AngelMzno/Sense-Termocarbox-V1/README.md

# Sense-Termocarbox-V1

Proyecto de migracion del equipo de termocarboxiterapia S Carbox de PIC + Nextion a STM32G431 + DWIN.

## Estado actual

- Bloque 0/1: requisitos y arquitectura de hardware documentados.
- Bloque 2: esquematico y layout PCB completados en EasyEDA Pro.
- Hardware: DRC sin fatal errors ni errores electricos, ratlines sin pendientes y Gerbers exportados para revision previa a fabricacion.
- Firmware: proyecto STM32CubeMX inicial en `Firrmware/`.

Ver `hardware/README.md` para el detalle de archivos de EasyEDA, BOM y Gerbers.
