AngelMzno/Sense-Termocarbox-V1/docs/05-diseno-pcb.md

# Diseño de PCB — Bloque 2

**Documento:** PCB-001 | **Revisión:** 01 | **Estado:** Layout completado para revisión Gerber — herramienta: EasyEDA Pro

## Estado del layout
- Esquemático capturado en EasyEDA Pro.
- PCB ruteada en 2 capas, con plano GND inferior.
- DRC sin fatal errors ni errores eléctricos.
- Ratlines revisadas sin conexiones pendientes.
- Gerber/Drill exportado como `hardware/Gerber_PCB1_2026-08-14.zip` para revisión previa a fabricación.
- Warnings conocidos: algunos conectores THT no tienen modelo 3D vinculado; no afecta fabricación.

## Política de componentes
MCU en SMD (obligatorio, no existe versión THT del STM32G431CBT6, encapsulado LQFP48). Todo lo demás (resistencias, capacitores, transistores/MOSFETs, diodos, reguladores) en THT por preferencia de facilidad de soldado y reparación en campo, salvo excepciones justificadas:
- Conversión 12V→5V usa módulo buck prearmado (IC interno SMD, pero módulo completo con headers, reemplazable como componente THT) para evitar pérdidas de potencia significativas de un regulador lineal en ese salto de voltaje.
- Capacitores cerámicos de desacoplo cercano del MCU en SMD 0603: C_VDD1, C_VDD2, C_VDD3, C_VDDA_100N y C_VDDA_1U. Esta excepción se justifica por integridad de señal y reducción de inductancia parásita: deben quedar lo más cerca posible de los pines VDD/VDDA del STM32G431CBT6 para filtrar ruido de alta frecuencia. No aplica al capacitor bulk C_BULK_3V3, que se mantiene THT.

## Fuente de reloj
Oscilador interno HSI16 del STM32G431 (sin cristal externo) — suficiente precisión para USART, PWM y ADC de esta aplicación; reduce componentes y puntos de falla mecánica frente a un cristal externo.

## Alimentación
- **12V → 5V:** módulo buck prearmado (tipo MP1584EN o LM2596), mínimo 1A de salida
- **5V → 3.3V:** LM1117T-3.3 (LDO fijo, TO-220/THT). Se descartó LM317 por dropout insuficiente (2-3V típico) frente al margen disponible de solo 1.7V (5V-3.3V)
- **Protección de entrada 12V:** diodo Schottky 1N5822 (THT, 3A) en serie, contra polaridad inversa
- **Desacoplo del MCU:** 100nF cerámico SMD 0603 en cada pin VDD + 1 capacitor bulk THT de 4.7-10µF. VDDA con 1µF SMD 0603 + 100nF SMD 0603 separados, con ferrita/inductor entre VDD y VDDA para aislar ruido digital de la parte analógica (crítico para lecturas limpias de ADC)

**Decisiones de captura cerradas:**
- VREF+ conectado a VDDA; no se usará referencia externa de ADC.
- VBAT conectado a 3.3V; no se usará batería de respaldo.
- LM1117T-3.3 con capacitor de entrada de 10µF entre +5V y GND, y capacitor de salida de 10µF entre 3.3V y GND, colocados cerca del regulador.
- Módulo buck mini DC-DC ajustable configurado/soldado a 5V antes de instalar. Pinout capturado: EN, IN+, GND, V+. EN amarrado a +12V para operación siempre habilitada; IN+ a +12V; GND a GND; V+ a +5V.

## Drivers de potencia
**MOSFET único para hotend y electroválvula:** IRLZ44N (TO-220, THT, nivel lógico) — mismo número de parte para ambos drivers, simplifica inventario de refacciones en campo.
- Resistencia de gate: 100-220Ω (limita corriente de carga inicial desde el GPIO)
- Resistencia de pull-down en gate: ~10kΩ (evita activación accidental del MOSFET durante arranque/reset del MCU, antes de que el firmware configure el GPIO)
- Electroválvula (carga inductiva): diodo flyback (1N4001 o equivalente) en paralelo con la bobina, para proteger el MOSFET del pico de voltaje inverso al apagar

**Driver del buzzer pasivo:** BS170 (MOSFET canal N, TO-92/THT) — mismo criterio de bajo consumo estático que el resto de drivers MOSFET, controlado por PWM desde PA6 (TIM3_CH1)
- Alimentación del buzzer desde +5V.
- Resistencia de gate: 220Ω.
- Resistencia pull-down en gate: 10kΩ.
- Componente de referencia capturado: PS1240P02BT, buzzer piezoeléctrico pasivo THT.

## Conectores capturados

- **J_DWIN:** BX-PH2.0-8PZZ, PH2.0 8 pines THT, LCSC C18077750. UART2 TTL/CMOS directo a PA9/PA10; no se usa MAX232/MAX3232. Pines RX4/TX4 quedan NC intencionalmente.
- **J_PEDAL:** bornera THT 2 pines paso 5.08mm. Un pin a GND/COM y el otro a PC13_PEDAL_NO con pull-up interno.
- **J_SWD:** header macho THT 2.54mm 1x5, LCSC C5156614. Incluye 3V3, SWDIO, SWCLK, NRST y GND.
- **J_HOTEND:** bornera THT 2 pines 5.08mm. Hotend entre +12V y drain de Q_HOTEND.
- **J_NTC_HOTEND:** header macho THT 2.54mm 1x2. NTC 100K B3950 en divisor contra R_NTC_PULLUP 100k a 3V3.
- **J_PRESSURE:** KF128-5.08-3P-AA, bornera THT 3 pines, LCSC C474953. +5V, GND y señal acondicionada hacia PA0.
- **J_DS18B20:** KF128-5.08-3P-AA, bornera THT 3 pines. 3V3, GND y DQ con pull-up 4.7k a 3V3.
- **J_BUZZER:** header macho THT 2.54mm 1x2. Buzzer alimentado desde +5V y conmutado por Q_BUZZER BS170.
- **J_TEST:** PH2.0 8 pines THT para medicion de banco. Pinout: 1 GND, 2 +12V, 3 +5V, 4 3V3, 5 PA0_PRESSURE_ADC, 6 PA1_NTC_ADC, 7 PB0_DS18B20_1WIRE, 8 PC13_PEDAL_NO. Serigrafia abreviada: GND, 12V, 5V, 3V3, PRESS, NTC, DS18, PED.

## Acondicionamiento de señales analógicas

**Sensor de presión (salida 5V → ADC 3.3V, PA0):**
- Divisor resistivo: R1=10kΩ, R2=15kΩ (relación 0.6 → escala 5V a 3.0V, con margen bajo el límite de 3.3V del ADC)
- Filtro RC anti-ruido: R=1kΩ, C=100nF (cutoff ~1.6kHz, filtra ruido de conmutación del PWM/electroválvula sin afectar velocidad de lectura)
- Protección: diodo zener 3.3-3.6V a tierra en el pin del ADC, como respaldo contra sobrevoltaje
- Justificación de nivel de protección elegido (Nivel 2: divisor + protección + filtro, sin aislamiento galvánico): todos los componentes comparten el mismo gabinete y tierra, por lo que un amplificador de aislamiento no está justificado en este diseño
