AngelMzno/Sense-Termocarbox-V1/hardware/Sense-Termocarbox-V1-BOM-v1.csv

No. | Quantity | Comment | Designator | Footprint | Value | Manufacturer Part | Manufacturer | Supplier Part | Supplier
1 | 3 | 10uF | C_BULK_3V3,C_LDO_IN,C_LDO_OUT | CAP-TH_BD4.0-P1.50-D0.8-FD | 10uF | KF106M025C05RR0VH2FP0 | Chengx(承兴) | C43846 | LCSC
2 | 5 | 100nF | C_PRESSURE_FILT,C_VDD1,C_VDD2,C_VDD3,C_VDDA_100N | CAP-TH_L5.0-W2.5-P5.00-D1.0 | 100nF | CC1H104MC1FD3F6C10MF | Dersonic(德尔创) | C254085 | LCSC
3 | 1 | 1uF | C_VDDA_1U | CAP-TH_L5.5-W3.5-P5.00-D1.2 | 1uF | FK26X7R1H105KRE06 | TDK | C2839237 | LCSC
4 | 1 | 1N4728ATR | D_PRESSURE_ZENER | DO-41_BD2.4-L4.7-P8.70-D0.9-RD |  | 1N4728ATR | onsemi(安森美) | C890041 | LCSC
5 | 1 | 1N5822 | D_PROT_12V | DO-201AD_BD5.3-L9.5-P13.50-D1.4-RD |  | 1N5822 | ST(意法半导体) | C915962 | LCSC
6 | 1 | 1N4001 | D_VALVE_FLYBACK | DO-41_BD2.6-L5.1-P9.00-D0.8-RD |  | 1N4001 | baocheng(宝乘) | C47018536 | LCSC
7 | 1 | RH3.5x0.8x9P52E | FB1 | BEAD-TH_BD3.5-L9.0-P13.00-D0.7 |  | RH3.5x0.8x9P52E | FH(风华) | C192455 | LCSC
8 | 1 | 4kHz | J_BUZZER | BUZ-TH_BD12.5-P5.00-D0.9 | 4kHz | PS1240P02BT | TDK | C76871 | LCSC
9 | 2 | KF128-5.08-3P-AA | J_DS18B20,J_PRESSURE | CONN-TH_3P-P5.08_KF128-5.08-3P |  | KF128-5.08-3P-AA | KEFA(科发) | C474953 | LCSC
10 | 2 | BX-PH2.0-8PZZ | J_DWIN,J_TEST | CONN-TH_8P-P2.00_BX-PH2.0-8PZZ |  | BX-PH2.0-8PZZ | Bossie(博锡) | C18077750 | LCSC
11 | 4 | 5.08-2A | J_HOTEND,J_PEDAL,J_PWR_IN,J_VALVE | CONN-TH_2P-P5.08_5.08-2A |  | 5.08-2A | DLL(德利) | C22394555 | LCSC
12 | 1 | HDR-M_2.54_1x2P | J_NTC_HOTEND | HDR-TH_2P-P2.54-V-M-1
13 | 1 | 2.54-1*5 | J_SWD | HDR-TH_5P-P2.54-V-M |  | 2.54-1*5 | ZHOURI(洲日) | C5156614 | LCSC
14 | 1 | BS170 | Q_BUZZER | TO-92-3_L4.9-W3.7-P1.27-L |  | BS170 | onsemi(安森美) | C111691 | LCSC
15 | 2 | IRLZ44NPBF | Q_HOTEND,Q_VALVE | TO-220-3_L10.0-W4.5-P2.54-T |  | IRLZ44NPBF | Infineon(英飞凌) | C38774 | LCSC
16 | 5 | 10kΩ | R_BOOT0_PD,R_BUZZER_PD,R_HOTEND_PD,R_PRESSURE_TOP,R_VALVE_PD | RES-TH_BD2.7-L6.2-P10.20-D0.4 | 10kΩ | MF1/4W-10K±1%-ST52 | VO(翔胜) | C2903232 | LCSC
17 | 1 | 220Ω | R_BUZZER_GATE | RES-TH_BD2.2-L6.5-P10.50-D0.6 | 220Ω | MF1/4W-220Ω±1% T | CCO(千志电子) | C127220 | LCSC
18 | 1 | 4.7kΩ | R_DS18B20_PULLUP | RES-TH_BD2.3-L6.5-P10.50-D0.5 | 4.7kΩ | MF1/4W-4.7KΩ±1% T | CCO(千志电子) | C119339 | LCSC
19 | 2 | 150Ω | R_HOTEND_GATE,R_VALVE_GATE | RES-TH_BD2.7-L6.2-P10.20-D0.4 | 150Ω | MF1/4W-150Ω±1%-ST52 | VO(翔胜) | C2903242 | LCSC
20 | 1 | 100kΩ | R_NTC_PULLUP | RES-TH_BD2.3-L6.5-P10.50-D0.5 | 100kΩ | MF1/4W-100KΩ±1% T | CCO(千志电子) | C119369 | LCSC
21 | 1 | 15kΩ | R_PRESSURE_BOT | RES-TH_BD2.7-L6.2-P10.20-D0.4 | 15kΩ | MF1/4W-15K±1%-ST26 | VO(翔胜) | C2903263 | LCSC
22 | 1 | 1kΩ | R_PRESSURE_FILT | RES-TH_BD2.7-L6.2-P10.20-D0.4 | 1kΩ | MF1/4W-1K±1%-ST52 | VO(翔胜) | C2903245 | LCSC
23 | 1 | STM32G431CBT6 | U1 | LQFP-48_L7.0-W7.0-P0.50-LS9.0-BL |  | STM32G431CBT6 | ST(意法半导体) | C529355 | LCSC
24 | 1 | HDR-M_2.54_1x4P | U_BUCK_5V | HDR-TH_4P-P2.54-V-M
25 | 1 | LM1117T-3.3 | U_LDO_3V3 | TO-220-3_L10.0-W4.5-P2.54-L |  | LM1117T-3.3 | HGSEMI(华冠) | C498321 | LCSC
