AngelMzno/Sense-Termocarbox-V1/hardware/Sense-Termocarbox-V1-esquematico-v1.pdf

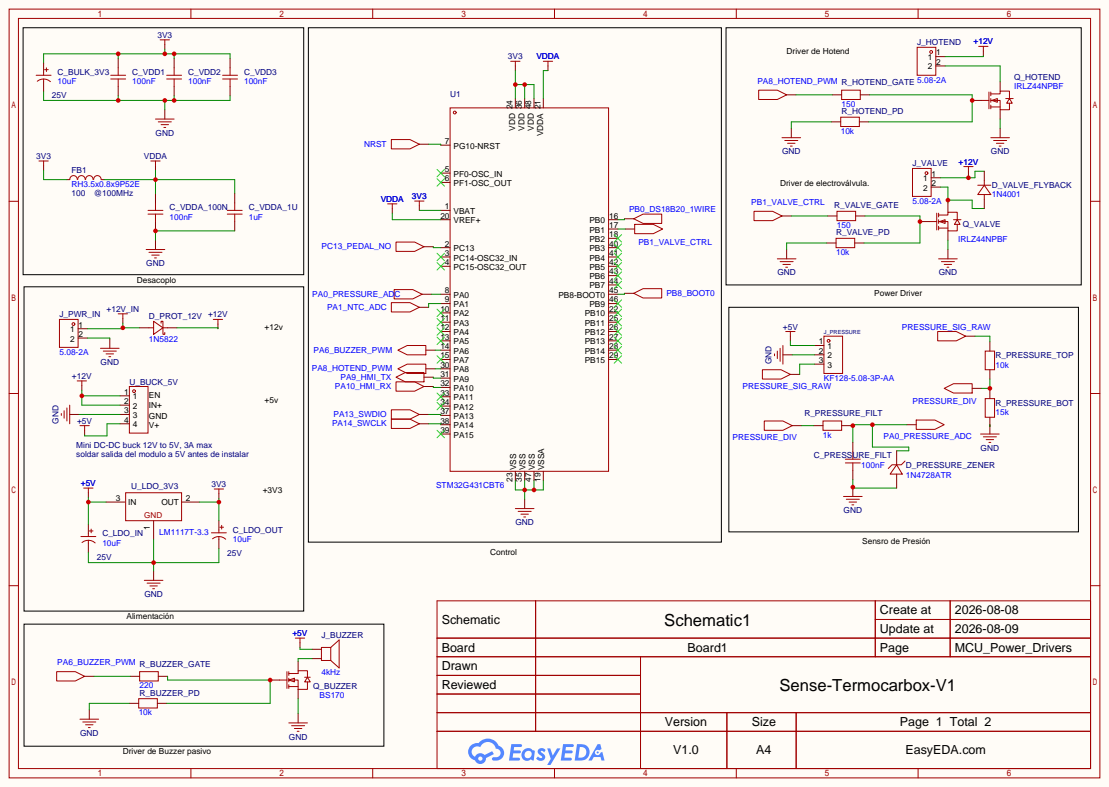
[picture p1: page 1]

Mini DC-DC buck 12V to 5V, 3A max
soldar salida del modulo a 5V antes de instalar

Schematic | Schematic1 | Create at | 2026-08-08

Update at | 2026-08-09

Board | Board1 | Page | MCU_Power_Drivers
Drawn | | Sense-Termocarbox-V1
Reviewed

Version | Size | Page 1 Total 2
V1.0 | A4 | EasyEDA.com

Driver de Buzzer pasivo

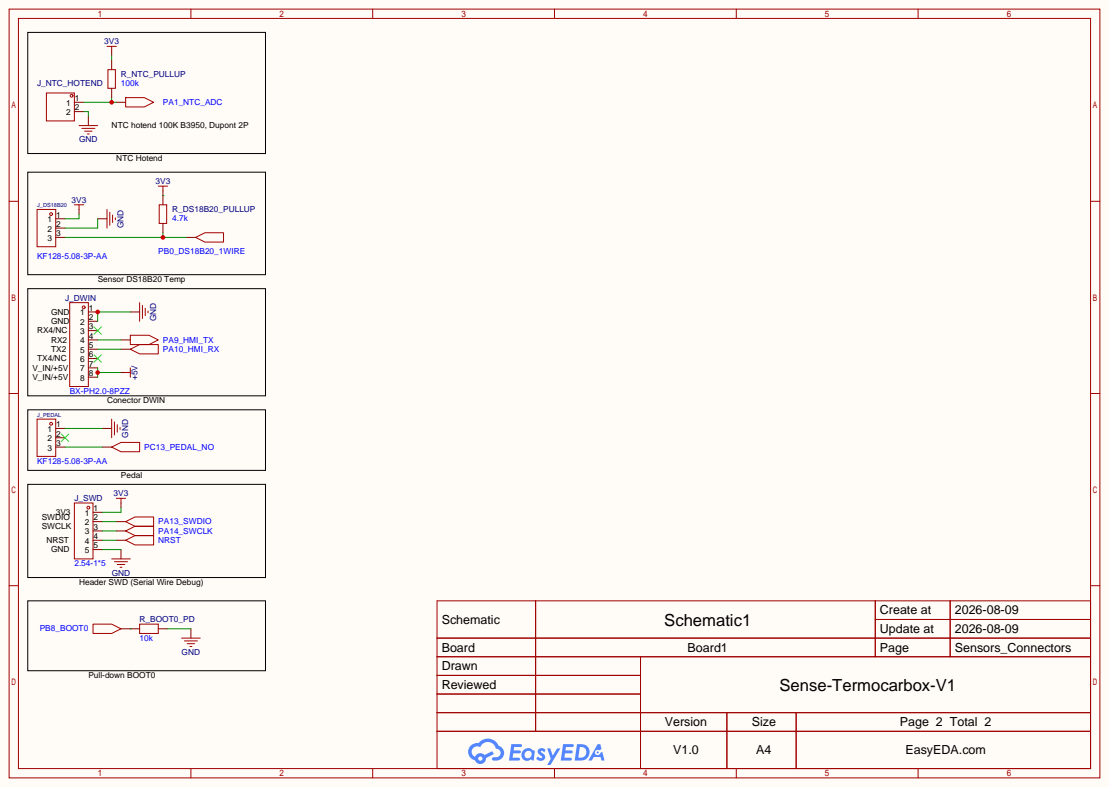
[picture p2: page 2]

Schematic | Schematic1 | Create at | 2026-08-09

Update at | 2026-08-09

Board | Board1 | Page | Sensors_Connectors
Drawn | | Sense-Termocarbox-V1
Reviewed

Version | Size | Page 2 Total 2
V1.0 | A4 | EasyEDA.com
