AngelMzno/Sense-Termocarbox-V1/(commit log)

2026-08-08 Init: repo vacío, proyecto en fase de definición de requisitos
2026-08-08 docs: actualizar requisitos (uso previsto, clasificación, normas aplicables) y agregar análisis de riesgos preliminar — alineado a NOM-241 Cap. 7-8
2026-08-08 docs: documentar arquitectura de hardware Bloque 1 (sensores, actuadores, regulación de presión)
2026-08-09 docs: agregar justificación de no usar MFC (controlador de flujo másico)
2026-08-09 docs: cerrar Bloque 1.3 (interfaces) y 1.4 (alimentación) en arquitectura de hardware
2026-08-09 docs: cerrar Bloque 1.6 (mapeo de pines validado en CubeMX) y agregar header de programación SWD
2026-08-09 docs: agregar diagrama de bloques Bloque 1.5 (cadena de gas y arquitectura eléctrica)
2026-08-09 docs: corregir error de sintaxis Mermaid en Diagrama 2 (comilla de pulgadas)
2026-08-09 docs: especificación de diseño de PCB Bloque 2 (componentes, drivers, acondicionamiento de señales, conectores)
2026-08-09 hardware: bloque de alimentación del MCU completo (VDD/VSS/VDDA/VSSA/VREF+/VBAT, desacoplo digital y analógico)
2026-08-09 hardware: bloques 3-4 completos (drivers de potencia IRLZ44N, buzzer BS170+PS1240P02BT) + BOM actualizado
2026-08-09 docs: actualizar arquitectura y PCB con decisiones de alimentación/buzzer, crear BOM inicial
2026-08-10 hardware: conectores completos (DWIN, pedal, SWD, hotend+NTC, sensor presión, DS18B20, buzzer) con correcciones de pines y valores
2026-08-10 hardware/docs: alinear esquemático final con documentación y BOM de conectores
2026-08-10 hardware: exportar esquemático PDF y BOM CSV desde EasyEDA (checkpoint post-ERC limpio)
    [Sense-Termocarbox-V1-BOM-v1.csv]
2026-08-14 hardware: completar layout PCB, gerbers y actualizar documentación de BOM/arquitectura
    [Sense-Termocarbox-V1-BOM-v1.csv]
